Tyson-Hu/Brain-Computer-Interface_Project/README.md

<a href="https://engineering.buffalo.edu/computer-science-engineering.html">UB</a>

# Brain-Computer-Interface Project




This is a UB senior capstone implementation from course CSE453 at University at Buffalo.

### Notice 
ADS1194 driver code are modified based on the repository from [ADS119X](https://github.com/chepo92/ADS119X) by [chepo92](https://github.com/chepo92).      
This code follows the GNU General Public License v3.0. For more information, check the LICENSE file. 

### Staff
- Client: Dr. Wenyao Xu, wenyaoxu@buffalo.edu
- Mentor: Prof. Kris Schindler, kds@buffalo.edu
- Work Group
  - Tianzhe Hu (Tyson), tianzheh@buffalo.edu
  - Zihan Lin, zlin29@buffalo.edu
  - Andrew Schaefer, schaefe2@buffalo.edu

### Contents
- [Implementation Report](https://github.com/Tyson-Hu/Brain-Computer-Interface_Project/blob/master/Doc/BCI_Implementation_Report.pdf)
- [User Manual](https://github.com/Tyson-Hu/Brain-Computer-Interface_Project/blob/master/Doc/BCI_Prototype_User_Manual.pdf)
- [PCB Schematics](https://github.com/Tyson-Hu/Brain-Computer-Interface_Project/blob/master/Doc/PCB_schematics.pdf) 
- [Presentation Slide](https://github.com/Tyson-Hu/Brain-Computer-Interface_Project/blob/master/Doc/Presentation.pptx)
- [Introduction Video](https://github.com/Tyson-Hu/Brain-Computer-Interface_Project/blob/master/Doc/Introduction_video.mp4)
- [Design Document[Deprecated]](https://github.com/Tyson-Hu/Brain-Computer-Interface_Project/blob/master/Doc/Project_Requirement_and_Design%5BDEPRECATED%5D.pdf)

### Required Software
- [Arduino IDE](https://www.arduino.cc/en/software): Compile & Program ADS1194 driver code
- [Waveforms](https://digilent.com/reference/software/waveforms/waveforms-3/start): Software for Analog Discovery 2 that used to generate waveforms

### Bill of Materials 
| Item | Unit Price | Quantity | Cost |
| ---- | ---- | ---- | ---- |
| [Microprocessor](https://www.digikey.com/en/products/detail/microchip-technology/ATMEGA328P-PU/1914589) | $4.66/ea | 1 | $4.66 |
| [Analog Digital Converter (ADC)](https://www.digikey.com/en/products/detail/texas-instruments/ADS1194CPAG/2440834) | $13.96/ea | 4 | $55.84 |
| [BlueTooth Module](https://www.digikey.com/en/products/detail/digilent,-inc./410-214/3902828) | $29.99/ea | 1 | $29.99 |
| [Voltage Regulator*](https://www.mouser.com/ProductDetail/Texas-Instruments/LP5907MFX-3.3-NOPB?qs=biyDIajrTn6NhrJCoL%2FdSQ%3D%3D) | $0.70/ea | 1 | $0.70 |
| [Lithium Ion Polymer Battery*](https://www.adafruit.com/product/1578) | $7.95/ea | 1 | $7.95 |
| Capacitors | $TBD/ea | 11+ | $TBD |
| Resistors | $TBD/ea | 1+ | $TBD |
| PCB Board* | $TBD/ea | 1 | $TBD |
| [Conductive Paste](https://shop.openbci.com/collections/frontpage/products/ten20-conductive-paste-8oz-jar) | $19.99/ea | 1 | $19.99 |
| [Electrodes](https://shop.openbci.com/products/openbci-gold-cup-electrodes) | $44.99/ea | 2 | $89.98 |
||| Total:| $201.16+ | 

**Item that not used on our prototye-board.*

### References
- chepo92. (n.d.). Chepo92/ADS119X: Texas Instrument ADS119X ADC converter library compatible with Arduino Ide. GitHub. https://github.com/chepo92/ADS119X
