Tyson-Hu/Brain-Computer-Interface_Project/(commit log)

2023-05-25 ADS1194 Driver Code Contribute by @lzhw5875d
2023-05-25 Add BOM and other resources
2023-05-25 Add item link & description for BOM
2023-05-25 Fix BOM layout
2023-05-25 Add PCB schematics
2023-05-25 Add file link for PCB schematic
